HexabitzPlatform/H3BR2x-Hardware/README.md

# H3BR2x-Hardware
Hexabitz 2-Digit 7-Segment display Module Hardware Design
