HexabitzPlatform/H3BR2x-Hardware/Rleased/BOM/H3BR2.xlsx

 |  | www.hexabitz.com info@hexabitz.com |  |  | Bill Of Materials
Customer | Hexabitz | Revision | 0
Project | Hexabitz Modules | Date | 2022-12-20
Board | 2-Digit 7-Segment Display (H3BR2) | Notes
Designator | Description | Manufacturer Part Number | Manufacturer | Octopart Url | Quantity
JP1 | Headers & Wire Housings Unshrouded 1 POS T/H | 5-146280-1 | TE Connectivity | https://octopart.com/5-146280-1-te+connectivity+%2F+amp-40259676?r=sp | 1
JP2 | Conn Unshrouded Header HDR 3 POS 2.54mm Solder ST Top Entry Thru-Hole Carton | 5-146281-3 | TE Connectivity | https://octopart.com/5-146281-3-te+connectivity+%2F+amp-39745942?r=sp | 1
R1 | RES SMD 0 OHM JUMPER 1/16W 0402 | AC0402JR-070RL | YAGEO [VR] | https://octopart.com/ac0402jr-070rl-yageo-21711084?r=sp | 1
R5, R7, R10, R12, R14, R17, R19, R21 | 100 OHM 1% Yageo Thick Film Resistors-smd 0402 | RC0402FR-07100RL | YAGEO [VR] | https://octopart.com/rc0402fr-07100rl-yageo-40952494?r=sp | 8
R2 | Thick Film Resistors - SMD 0603 270 Ohm 5% Tol | ERJ-3GEYJ271V | Panasonic | https://octopart.com/erj-3geyj271v-panasonic-55560546?r=sp | 1
R3 ,R4, R6, R8, R9, R11, R13, R15, R16, R18, R20 | RES 10K OHM 1% Yageo Thick Film Resistors -SMD 1/16W 0402 | RC0402FR-0710KL | YAGEO [VR] | https://octopart.com/rc0402fr-0710kl-yageo-55458461?r=sp | 11
C1, C2, C4, C6 | Cap Ceramic 0.1uF 16V X7R 10% SMD 0402 125°C Paper T/R | C0402C104K4RAL | KEMET | https://octopart.com/c0402c104k4raltu-kemet-9144042?r=sp | 4
C5 | CAP CER 1 UF 16V X7R 0805 | CC0805KKX7R7BB105 | YAGEO [VA] | https://octopart.com/cc0805kkx7r7bb105-yageo-8376555?r=sp | 1
C7, C3 | CAP TANT 4.7 UF 10V 20% 0805 | 10TPU4R7MSI | Panasonic | https://octopart.com/10tpu4r7msi-panasonic-29487748?r=sp | 2
FB1 | Ind chip Bead Multi-Layer 30 ohms 25% 100MHZ Ferrite 1,5A 0603Punched paper T/R | MMZ1608Y300BTA00 | TDK | https://octopart.com/mmz1608y300bta00-tdk-7906990?r=sp | 1
D1 | Red 0603 130° Clear 54 mcd 2 V Surface Mount ChipLED | VLMS1300-GS08 | Vishay | https://octopart.com/vlms1300-gs08-vishay-21709201?r=sp&s=0nXJNjGsSbWwqfqWlZv0EA | 1
LED1 | Numeric Red 7-Segment 2 Character Common Cathode 2V 20mA - 0.56 inch - 18-DIP | LTD-6940HR | Lite-On | https://octopart.com/ltd-6940hr-lite-on-2440736?r=sp | 1
Q1, Q2, Q3, Q5, Q6, Q8, Q9, Q10 | Trans GP BJT PNP 40V 0.2A 330mW Automotive 3-Pin SOT-23 T/R | MMBT3906LT1HTSA1 | Infineon | https://octopart.com/mmbt3906lt1htsa1-infineon-21387160?r=sp | 8
Q4, Q7 | Transistor, Bipolar, Si, NPN, General Purpose, VCEO 40VDC, IC 200mA, PD 225mW, SOT-23 | MMBT3904LT1G | ON Semiconductor | https://octopart.com/mmbt3904lt1g-on+semiconductor-3280?r=sp | 2
U1 | MCU 32-Bit ARM Cortex-M0+ RISC 512kByte Flash 1.7V to 3.6V 48-Pin UFQFPN Tray | STM32G0B1CEU6N | STMicroelectronics | https://octopart.com/stm32g0b1ceu6n-stmicroelectronics-116364672?r=sp | 1
X1 | 8,0000MHZ 33pF SMD MURATA Resonators | CSTNE8M00G550000R0 | Murata | https://octopart.com/cstne8m00g550000r0-murata-91406934?r=sp | 1
