HexabitzPlatform/H3BR2x-Hardware/Documentation/H3BR2 Schematics.pdf

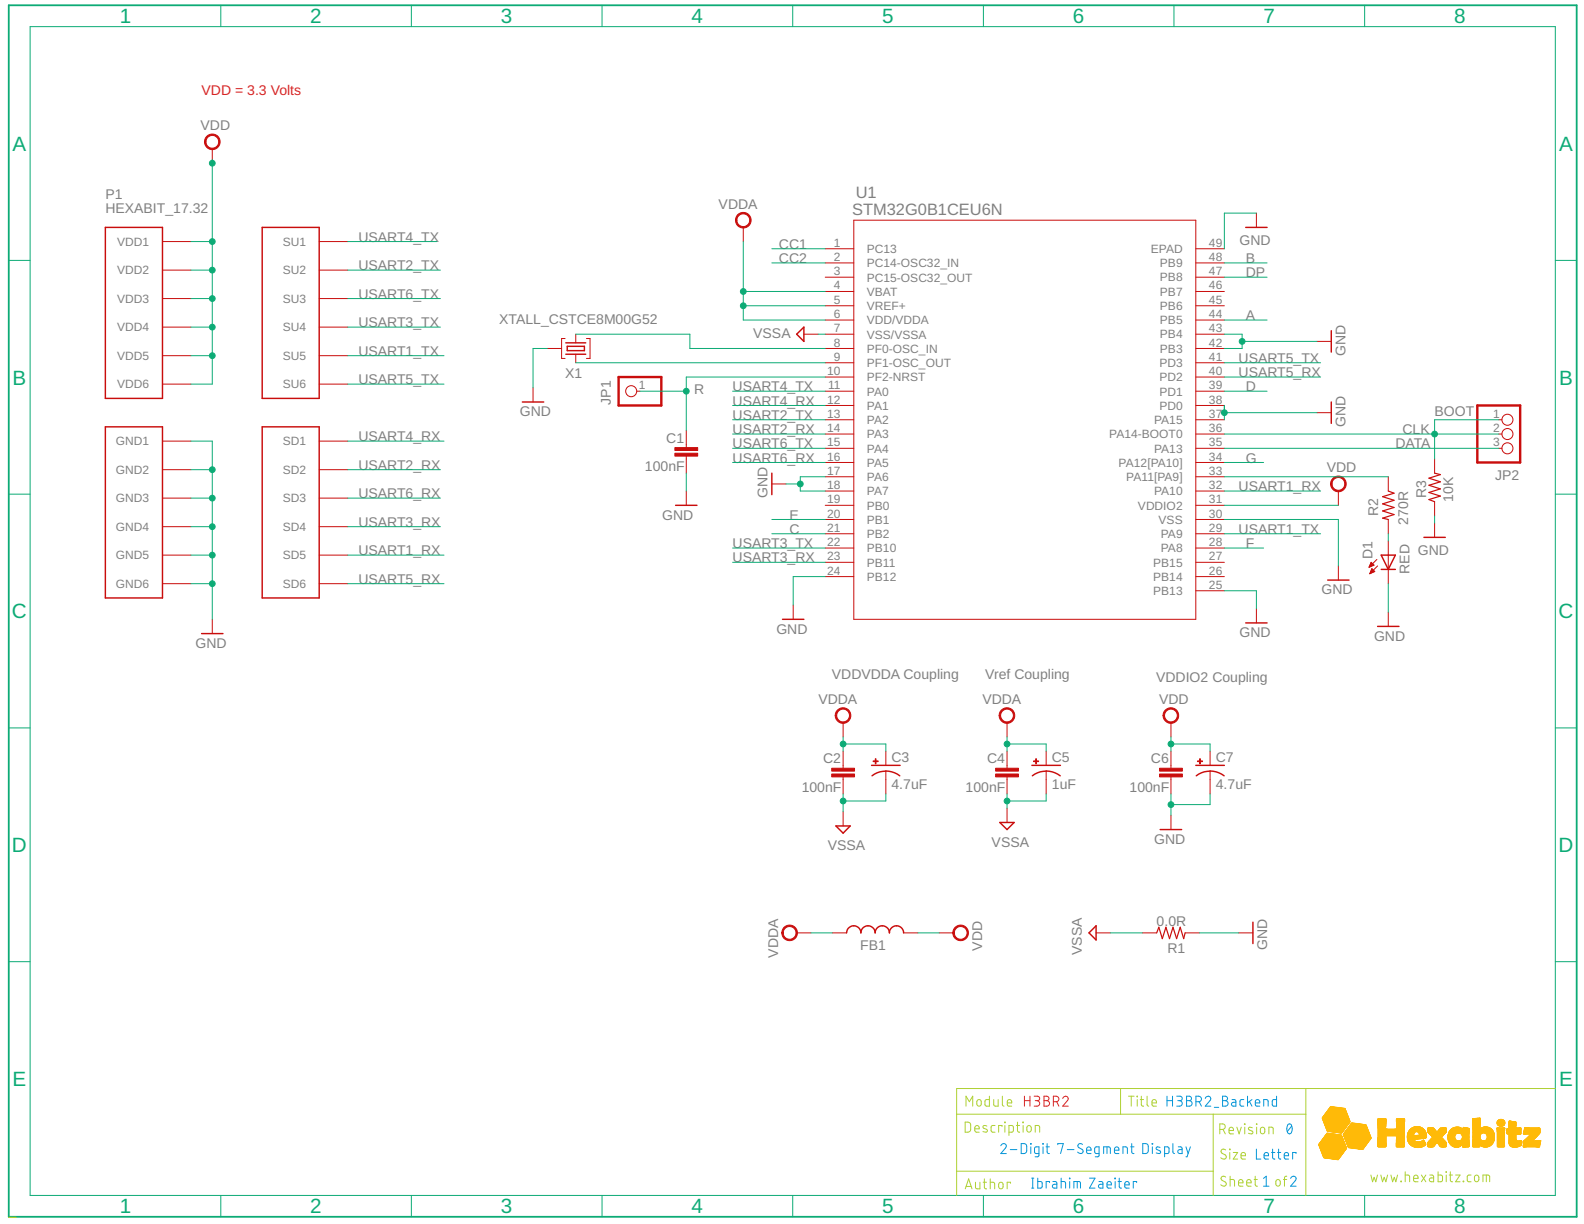
[picture p1: page 1]

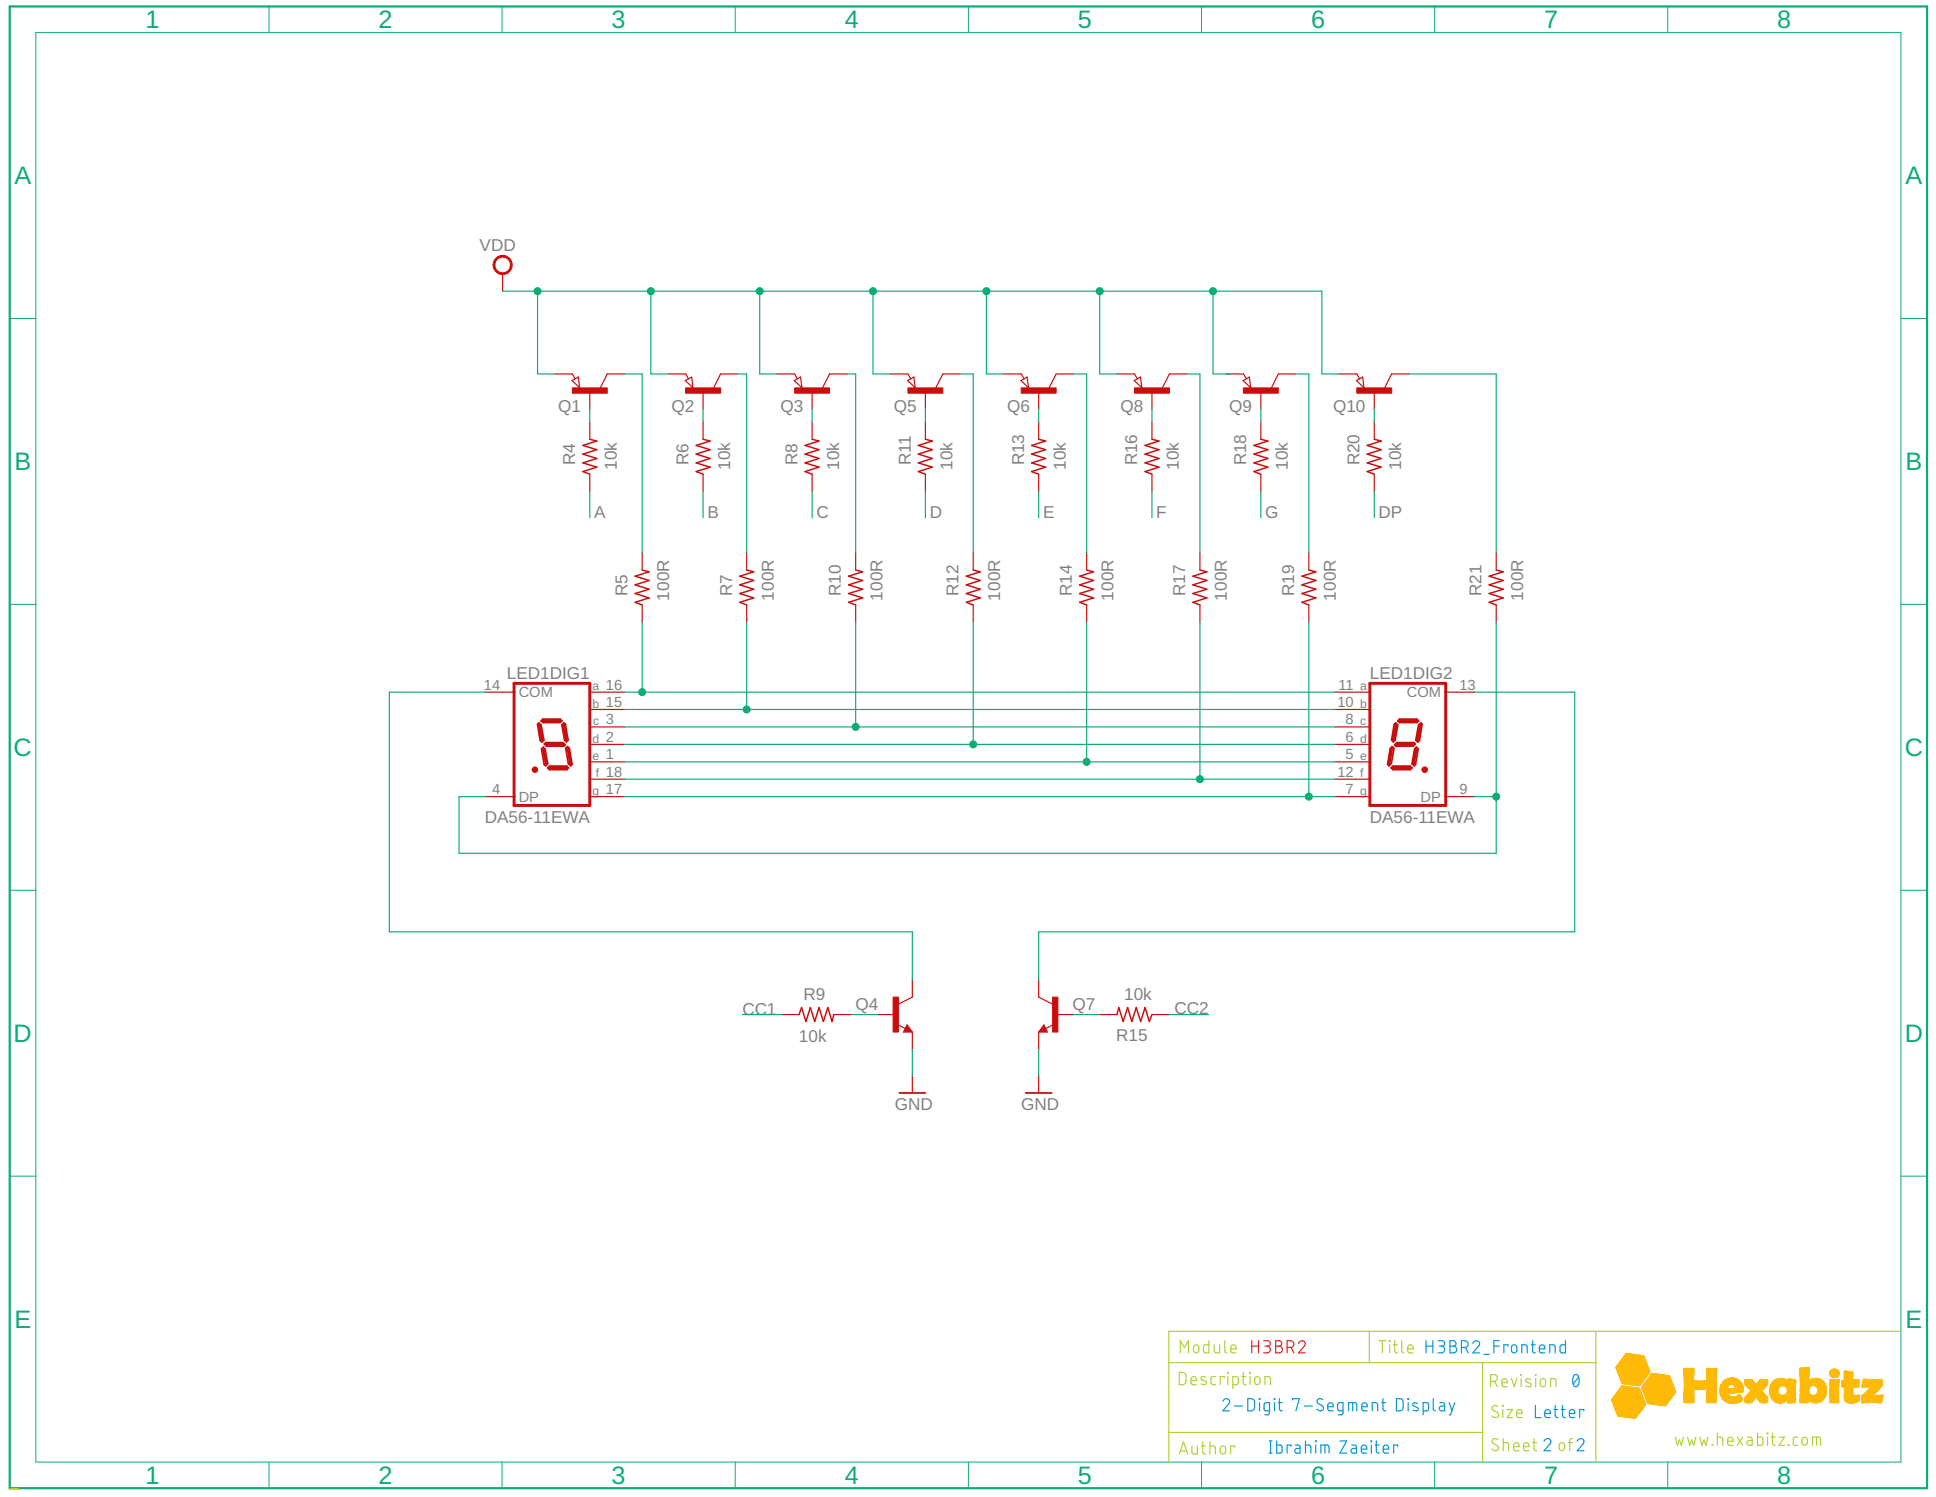
[picture p2: page 2]

3 cd | 8 cd
e 1 | 5 e
18 | 12
17 | 7
