HexabitzPlatform/H3BR2x-Hardware/Design/H3BR2.brd

## EAGLE design Design/H3BR2.brd (2024-02-13)

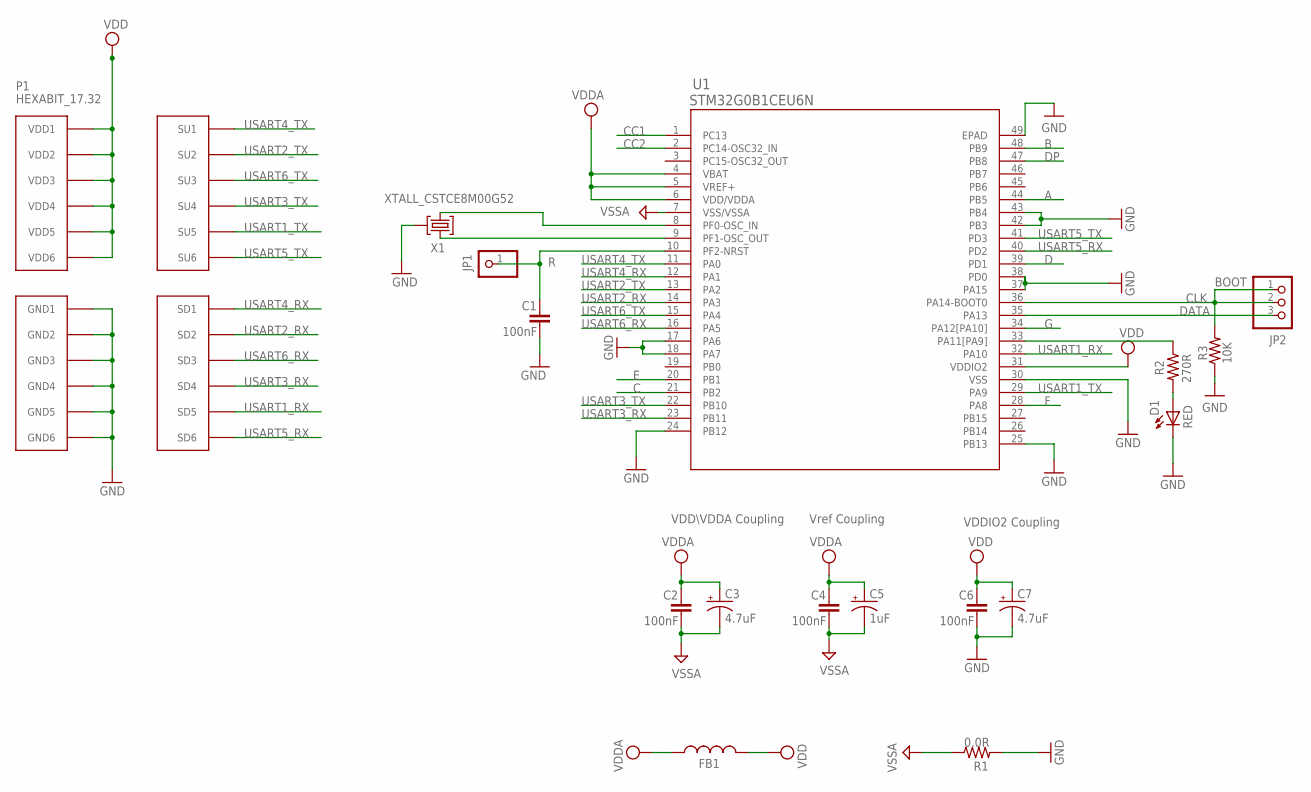
[picture p3: schematic H3BR2.sch, sheet 1]

Parts:
C1, C2, C4, C6: 100nF; C-0402
C3, C7: 4.7uF; C-0805-POL
C5: 1uF; C-0805-POL
D1: RED; VLMS1300-GS08; MPN VLMS1300-GS08
FB1: FB-0603
JP1: R; 1X01
JP2: PINHD-1X3; 1X03
P1: HEXABIT_17.32
R1: 0.0R; R-0402
R2: 270R; R-0603
R3: 10K; R-0402
U1: STM32G0B1CEU6N; QFN_B1CEU6_STM-L
X1: XTALL_CSTCE8M00G52

Connections:
A: U1.44 (PB5); also elsewhere on the board
B: U1.48 (PB9); also elsewhere on the board
C: U1.21 (PB2); also elsewhere on the board
CC1: U1.1 (PC13); also elsewhere on the board
CC2: U1.2 (PC14-OSC32_IN); also elsewhere on the board
CLK: JP2.1, JP2.2, R3.2, U1.36 (PA14-BOOT0)
D: U1.39 (PD1); also elsewhere on the board
DATA: JP2.3, U1.35 (PA13)
DP: U1.47 (PB8); also elsewhere on the board
E: U1.20 (PB1); also elsewhere on the board
F: U1.28 (PA8); also elsewhere on the board
G: U1.34 (PA12[PA10]); also elsewhere on the board
GND: C1.2, C6.2, C7.2 (-), D1.C, P1.PAD_PD7 (GND1), P1.PAD_PD8 (GND2), P1.PAD_PD9 (GND3), P1.PAD_PD10 (GND4), P1.PAD_PD11 (GND5), P1.PAD_PD12 (GND6), R1.2, R3.1, U1.17 (PA6), U1.18 (PA7), U1.24 (PB12), U1.25 (PB13), U1.30 (VSS), U1.37 (PA15), U1.38 (PD0), U1.42 (PB3), U1.43 (PB4), U1.49 (EPAD), X1.P$2 (2); also elsewhere on the board
unnamed: D1.A, R2.2
unnamed: R2.1, U1.33 (PA11[PA9])
unnamed: U1.9 (PF1-OSC_OUT), X1.P$1 (1)
unnamed: U1.8 (PF0-OSC_IN), X1.P$3 (3)
unnamed: C1.1, JP1.1, U1.10 (PF2-NRST)
USART1_RX: P1.PAD_PD5 (SD5), U1.32 (PA10)
USART1_TX: P1.PAD_PU5 (SU5), U1.29 (PA9)
USART2_RX: P1.PAD_PD2 (SD2), U1.14 (PA3)
USART2_TX: P1.PAD_PU2 (SU2), U1.13 (PA2)
USART3_RX: P1.PAD_PD4 (SD4), U1.23 (PB11)
USART3_TX: P1.PAD_PU4 (SU4), U1.22 (PB10)
USART4_RX: P1.PAD_PD1 (SD1), U1.12 (PA1)
USART4_TX: P1.PAD_PU1 (SU1), U1.11 (PA0)
USART5_RX: P1.PAD_PD6 (SD6), U1.40 (PD2)
USART5_TX: P1.PAD_PU6 (SU6), U1.41 (PD3)
USART6_RX: P1.PAD_PD3 (SD3), U1.16 (PA5)
USART6_TX: P1.PAD_PU3 (SU3), U1.15 (PA4)
VDD: C6.1, C7.1 (+), FB1.2, P1.PAD_PU7 (VDD1), P1.PAD_PU8 (VDD2), P1.PAD_PU9 (VDD3), P1.PAD_PU10 (VDD4), P1.PAD_PU11 (VDD5), P1.PAD_PU12 (VDD6), U1.31 (VDDIO2); also elsewhere on the board
VDDA: C2.1, C3.1 (+), C4.1, C5.1 (+), FB1.1, U1.4 (VBAT), U1.5 (VREF+), U1.6 (VDD/VDDA)
VSSA: C2.2, C3.2 (-), C4.2, C5.2 (-), R1.1, U1.7 (VSS/VSSA)

Notes on the sheet:
Vref Coupling
VDDIO2 Coupling
VDD\VDDA Coupling
BOOT

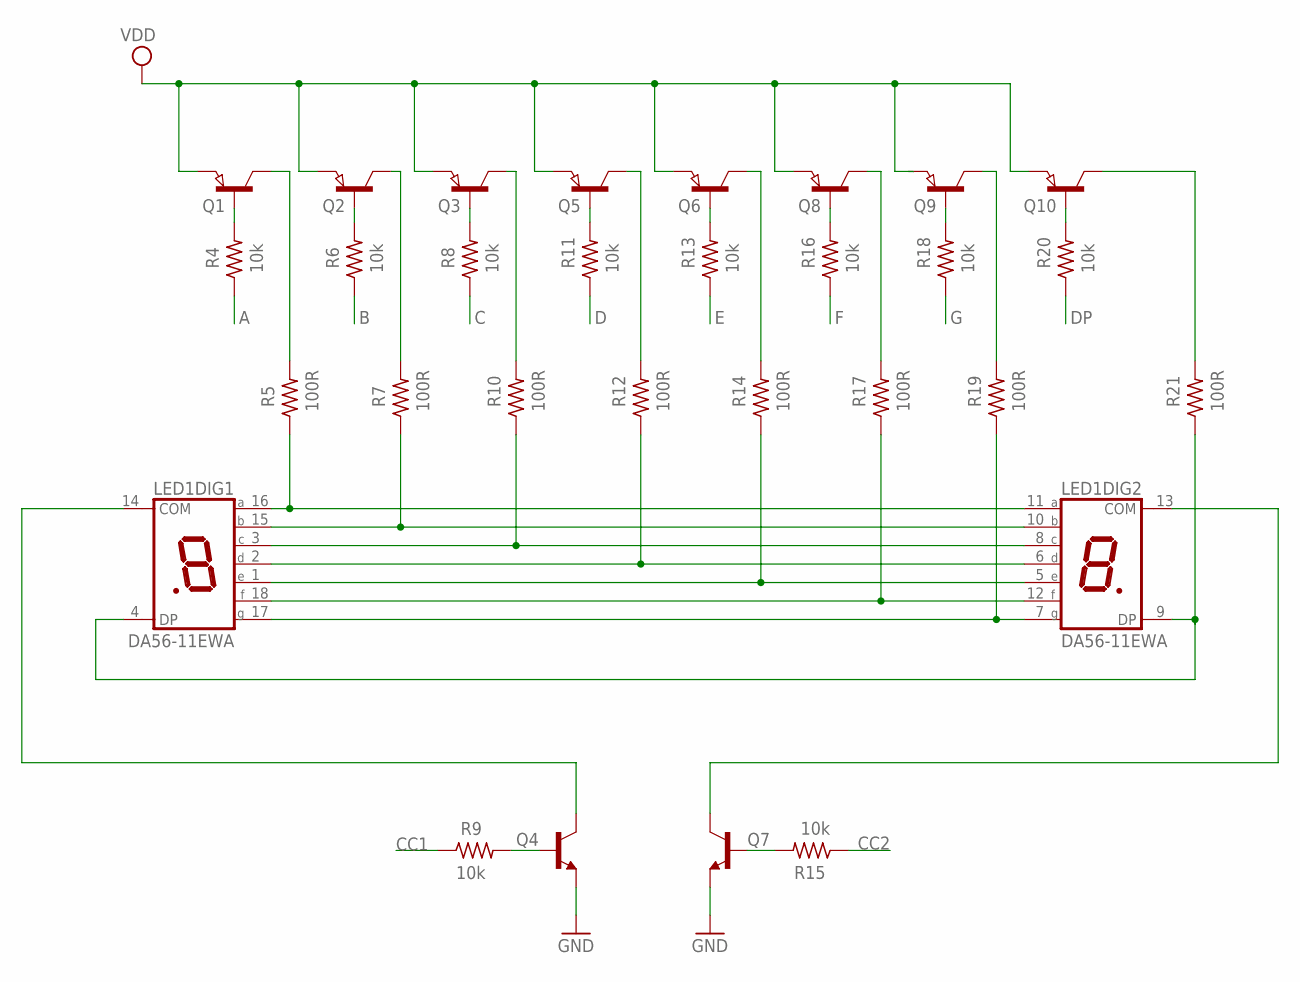
[picture p4: schematic H3BR2.sch, sheet 2]

Parts:
LED1: DA56-11EWA; DA56; MPN LTD-6940HR
Q1, Q2, Q3, Q5, Q6, Q8, Q9, Q10: SEMICON-SMD-IPC_PNP-TRANSISTOR_SOT23; SEMICON-SMD-IPC_SOT23
Q4, Q7: MMBT3904LT1
R4, R6, R8, R9, R11, R13, R15, R16, R18, R20: 10k; R-0402
R5, R7, R10, R12, R14, R17, R19, R21: 100R; R-0402

Connections:
A: R4.1; also elsewhere on the board
B: R6.1; also elsewhere on the board
C: R8.1; also elsewhere on the board
CC1: R9.1; also elsewhere on the board
CC2: R15.1; also elsewhere on the board
D: R11.1; also elsewhere on the board
DP: R20.1; also elsewhere on the board
E: R13.1; also elsewhere on the board
F: R16.1; also elsewhere on the board
G: R18.1; also elsewhere on the board
GND: Q4.2 (E), Q7.2 (E); also elsewhere on the board
unnamed: LED1.10 (B), LED1.15 (B), R7.1
unnamed: Q1.1 (B), R4.2
unnamed: Q2.1 (B), R6.2
unnamed: Q9.3 (C), R19.2
unnamed: Q8.3 (C), R17.2
unnamed: Q6.3 (C), R14.2
unnamed: Q5.3 (C), R12.2
unnamed: Q3.3 (C), R10.2
unnamed: Q2.3 (C), R7.2
unnamed: Q1.3 (C), R5.2
unnamed: Q3.1 (B), R8.2
unnamed: Q5.1 (B), R11.2
unnamed: Q6.1 (B), R13.2
unnamed: Q8.1 (B), R16.2
unnamed: Q9.1 (B), R18.2
unnamed: Q10.1 (B), R20.2
unnamed: LED1.11 (A), LED1.16 (A), R5.1
unnamed: LED1.4 (DP), LED1.9 (DP), R21.1
unnamed: LED1.3 (C), LED1.8 (C), R10.1
unnamed: LED1.2 (D), LED1.6 (D), R12.1
unnamed: LED1.1 (E), LED1.5 (E), R14.1
unnamed: LED1.12 (F), LED1.18 (F), R17.1
unnamed: LED1.7 (G), LED1.17 (G), R19.1
unnamed: LED1.14 (COM), Q4.3 (C)
unnamed: LED1.13 (COM), Q7.3 (C)
unnamed: Q7.1 (B), R15.2
unnamed: Q4.1 (B), R9.2
unnamed: Q10.3 (C), R21.2
VDD: Q1.2 (E), Q2.2 (E), Q3.2 (E), Q5.2 (E), Q6.2 (E), Q8.2 (E), Q9.2 (E), Q10.2 (E); also elsewhere on the board

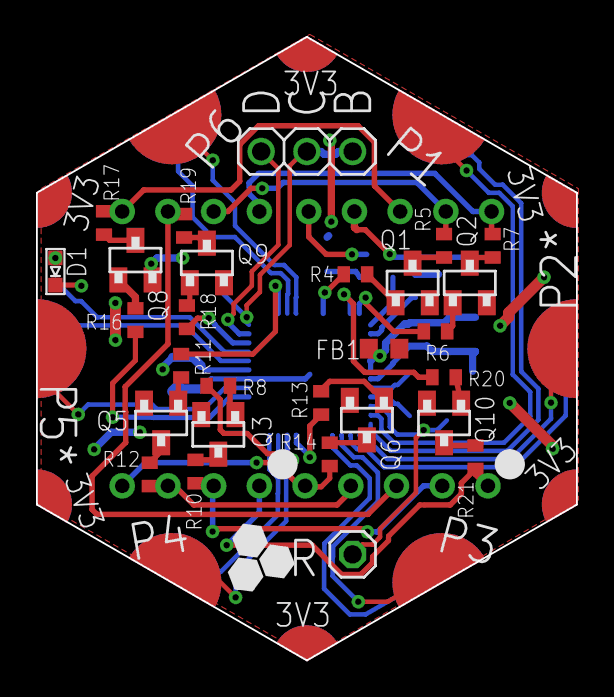
[picture p5: board H3BR2.brd from above]

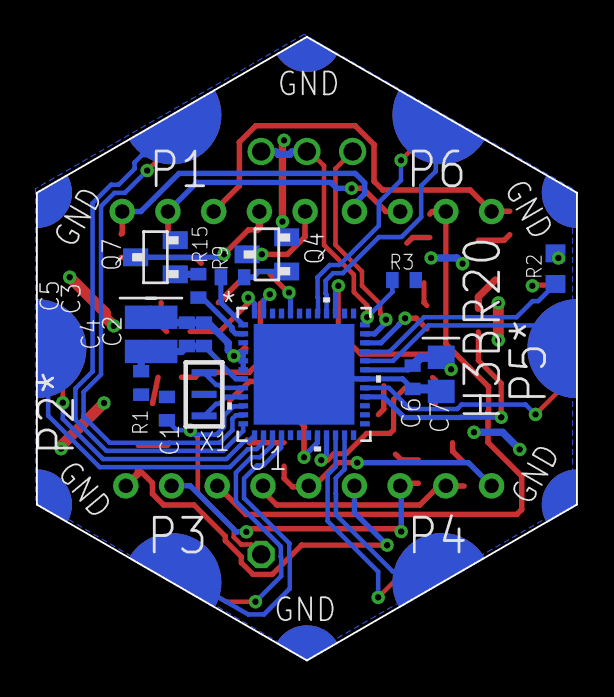
[picture p6: board H3BR2.brd from below]

Board: 2 copper layers, 30.0 x 34.6 mm, 46 parts (16 on the bottom side), 61 nets.
