HexabitzPlatform/H3BR2x-Hardware/(commit log)

2022-12-28 The first version of the module with stm32g0 MCU
    [H3BR20.brd, H3BR20.sch, H3BR20.xlsx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]
2023-02-13 -Correcting some documentaion issues
    [H3BR20.xlsx]
2023-03-23 fix bom
    [H3BR20.xlsx]
2024-02-13 -Fixing Documentation Issues
    [H3BR2.brd, H3BR2.sch, H3BR2.xlsx, H3BR20.xlsx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]
