HexabitzPlatform/H3BR2x-Hardware/(notices)

Notices in the files:
parts and their libraries:
HEXABITZ_ICs: COPYRIGHT: Copyright (C) 2022 Ultra Librarian. All rights reserved.
